Klocman/MSCR/Documentation/Photos/3.jpg

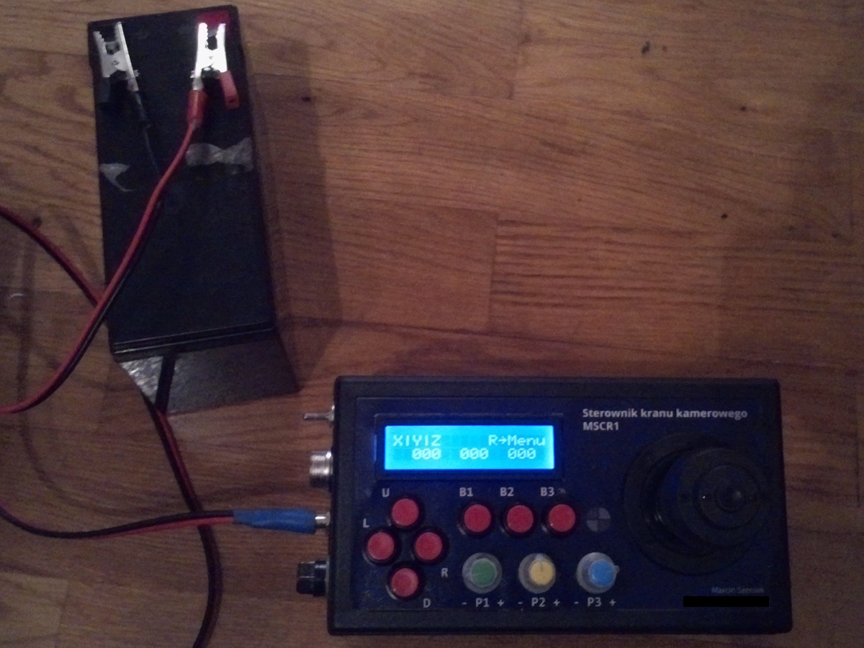
Documentation/Photos/3.jpg
