Klocman/MSCR/Documentation/Photos/4.jpg

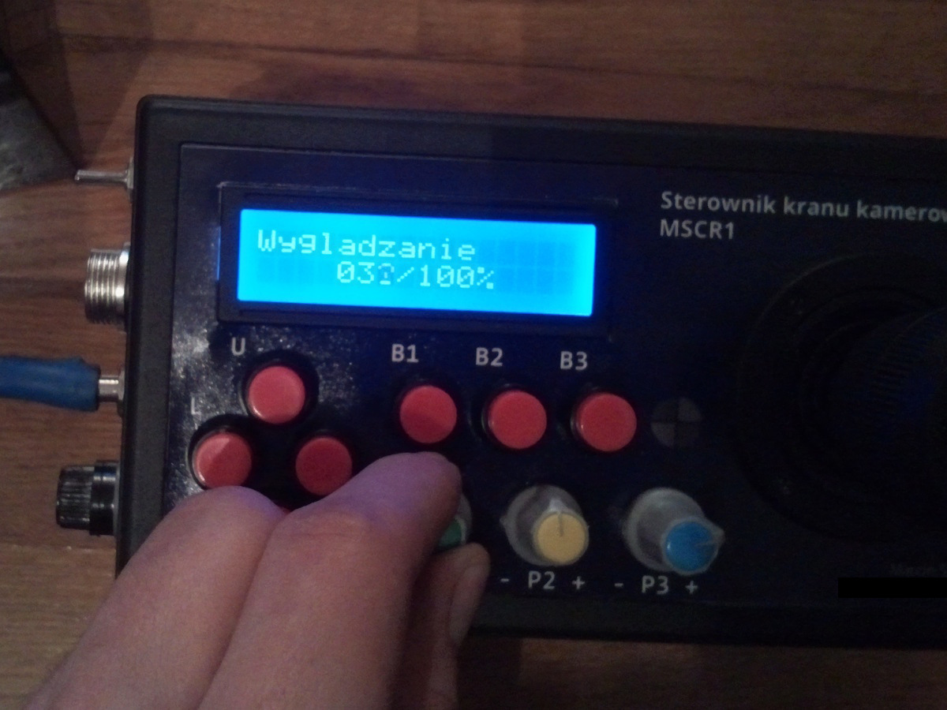
Documentation/Photos/4.jpg
