Klocman/MSCR/Documentation/Photos/5.jpg

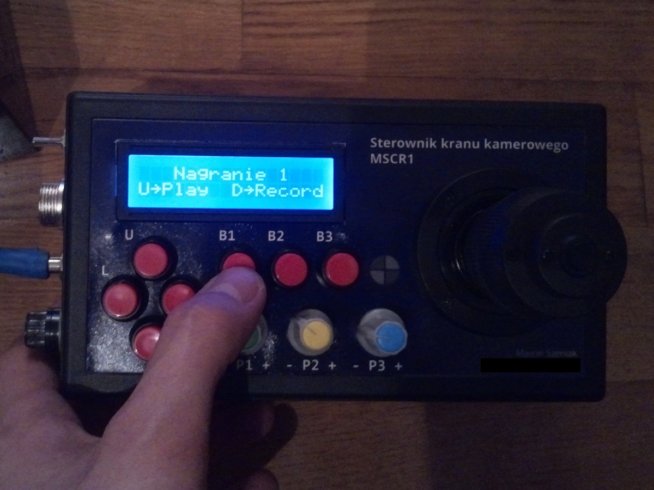
Documentation/Photos/5.jpg
