Klocman/MSCR/Documentation/Photos/7.jpg

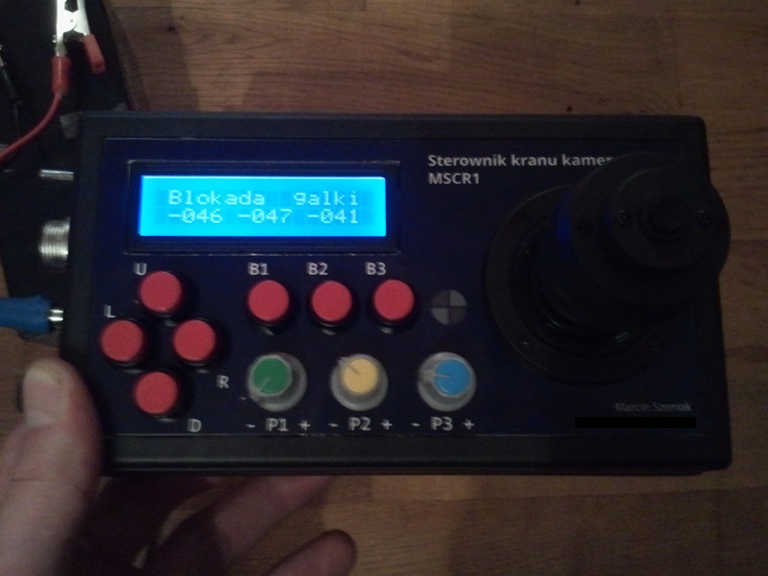
Documentation/Photos/7.jpg
