Klocman/MSCR/Hardware/main.brd

## EAGLE design Hardware/main.brd (2016-10-11)

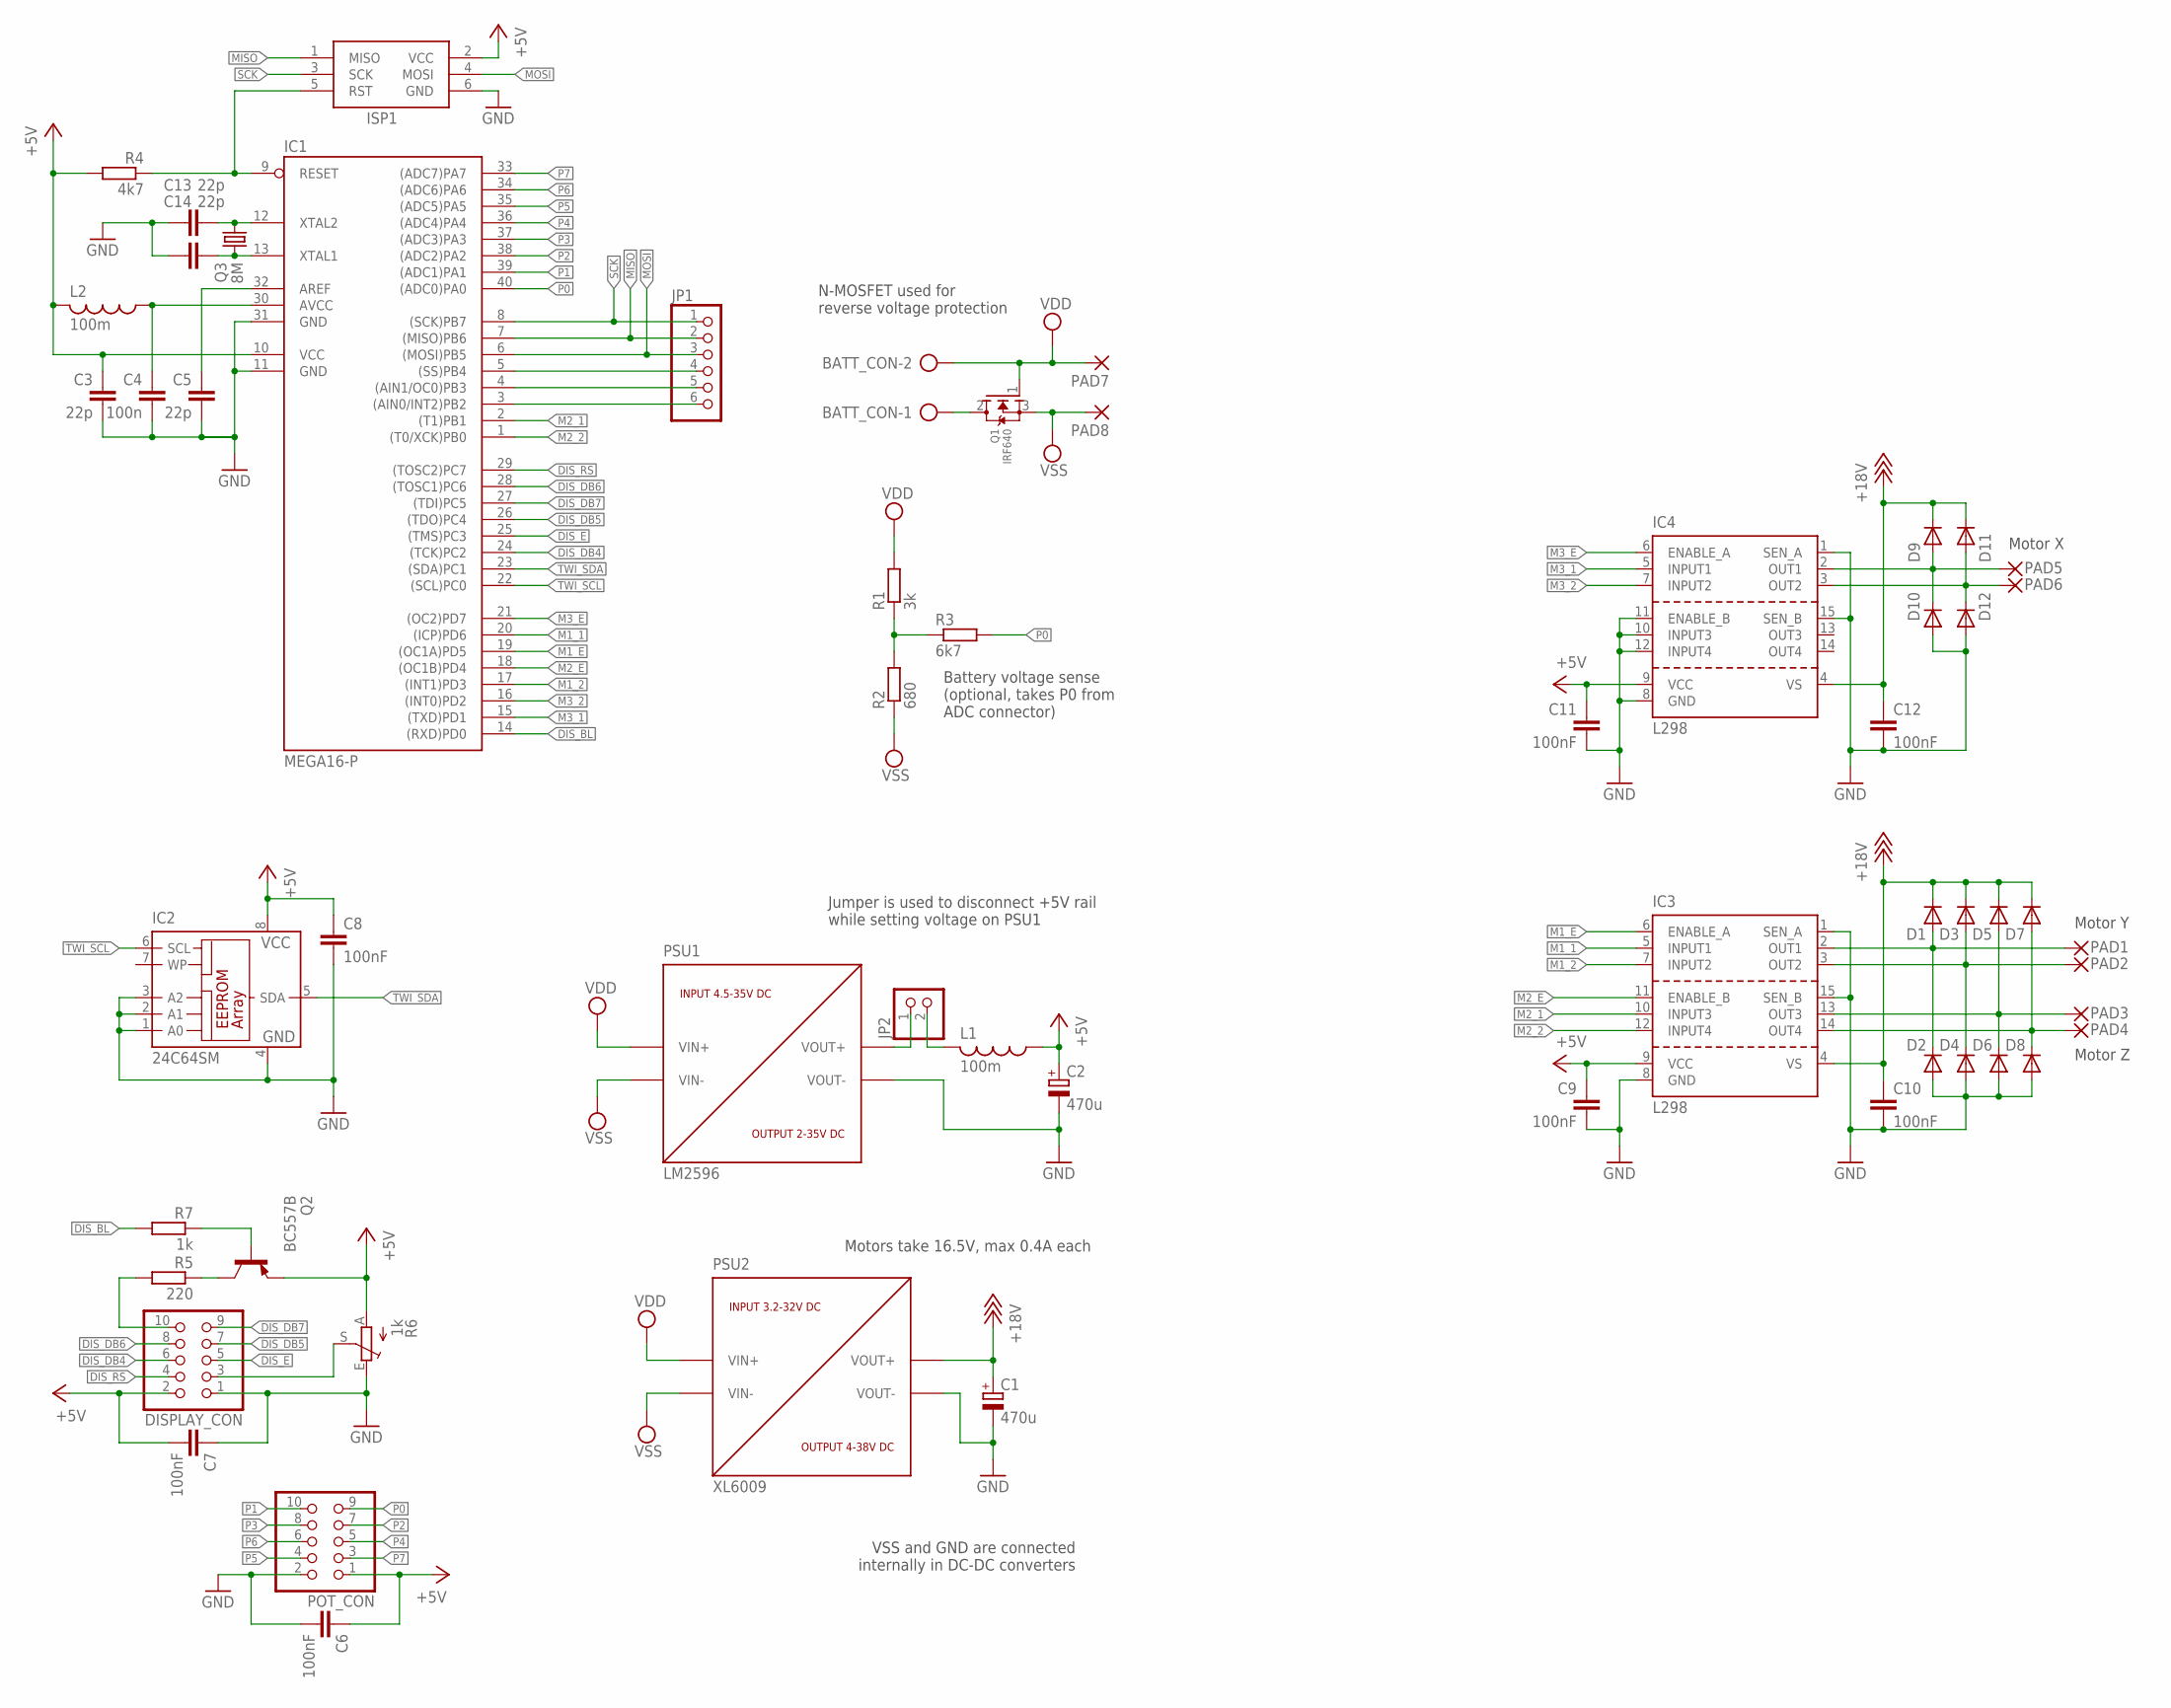
[picture p8: schematic main.sch]

Parts:
BATT_CON: AK500/2-H
C1: 470u; E3,5-8
C2: 470u; E5-8,5
C3, C5, C13, C14: 22p; C025-025X050
C4: 100n; C025-025X050
C6: 100nF; C025-025X050
C7, C8: 100nF; C050-024X044
C9, C10, C11, C12: 100nF; C075-032X103
D1, D2, D3, D4, D5, D6, D7, D8, D9, D10, D11, D12: UF4003; DO41-10
DISPLAY_CON: PINHD-2X5; 2X05
IC1: MEGA16-P; DIL40
IC2: 24C64SM; SO-08M
IC3, IC4: L298; MULTIWATT-15
ISP1: AVRISP-6; AVRISP
JP1: PINHD-1X6; 1X06
JP2: PINHD-1X2; 1X02
L1, L2: 100m; 0204/7
PAD1, PAD2, PAD3, PAD4, PAD5, PAD6, PAD7, PAD8: 2,54/1,1KLOCWIRE1; KLOCWIRE1
POT_CON: PINHD-2X5; 2X05
PSU1: LM2596; DC-DC_CONV_MODULE
PSU2: XL6009; DC-DC_CONV_MODULE
Q1: IRF640; TO220V
Q2: BC557B; TO92-EBC
Q3: 8M; TC26V
R1: 3k; 0204/7
R2: 680; 0204/7
R3: 6k7; 0204/5
R4: 4k7; 0204/5
R5: 220; 0204/7
R6: 1k; CA6V
R7: 1k; 0204/7

Connections:
+5V: C2.+, C3.1, C6.1, C7.2, C8.1, C9.1, C11.1, DISPLAY_CON.2, IC1.10 (VCC), IC2.8 (VCC), IC3.9 (VCC), IC4.9 (VCC), ISP1.2 (VCC), L1.1, L2.2, POT_CON.1, Q2.E, R4.2, R6.A
+18V: C1.+, C10.1, C12.1, D1.C, D3.C, D5.C, D7.C, D9.C, D11.C, IC3.4 (VS), IC4.4 (VS), PSU2.OUT+ (VOUT+)
DIS_BL: IC1.14 ((RXD)PD0), R7.2
DIS_DB4: DISPLAY_CON.6, IC1.24 ((TCK)PC2)
DIS_DB5: DISPLAY_CON.7, IC1.26 ((TDO)PC4)
DIS_DB6: DISPLAY_CON.8, IC1.28 ((TOSC1)PC6)
DIS_DB7: DISPLAY_CON.9, IC1.27 ((TDI)PC5)
DIS_E: DISPLAY_CON.5, IC1.25 ((TMS)PC3)
DIS_RS: DISPLAY_CON.4, IC1.29 ((TOSC2)PC7)
DIS_VO: DISPLAY_CON.3, R6.S
GND: C1.-, C2.-, C3.2, C4.2, C5.2, C6.2, C7.1, C8.2, C9.2, C10.2, C11.2, C12.2, C13.2, C14.2, D2.A, D4.A, D6.A, D8.A, D10.A, D12.A, DISPLAY_CON.1, IC1.11 (GND), IC1.31 (GND), IC2.1 (A0), IC2.2 (A1), IC2.3 (A2), IC2.4 (GND), IC3.1 (SEN_A), IC3.8 (GND), IC3.15 (SEN_B), IC4.1 (SEN_A), IC4.8 (GND), IC4.10 (INPUT3), IC4.11 (ENABLE_B), IC4.12 (INPUT4), IC4.15 (SEN_B), ISP1.6 (GND), POT_CON.2, PSU1.OUT- (VOUT-), PSU2.OUT- (VOUT-), R6.E
M1_1: IC1.20 ((ICP)PD6), IC3.5 (INPUT1)
M1_2: IC1.17 ((INT1)PD3), IC3.7 (INPUT2)
M1_E: IC1.19 ((OC1A)PD5), IC3.6 (ENABLE_A)
M2_1: IC1.2 ((T1)PB1), IC3.10 (INPUT3)
M2_2: IC1.1 ((T0/XCK)PB0), IC3.12 (INPUT4)
M2_E: IC1.18 ((OC1B)PD4), IC3.11 (ENABLE_B)
M3_1: IC1.15 ((TXD)PD1), IC4.5 (INPUT1)
M3_2: IC1.16 ((INT0)PD2), IC4.7 (INPUT2)
M3_E: IC1.21 ((OC2)PD7), IC4.6 (ENABLE_A)
MISO: IC1.7 ((MISO)PB6), ISP1.1 (MISO), JP1.2
MOSI: IC1.6 ((MOSI)PB5), ISP1.4 (MOSI), JP1.3
unnamed: JP2.1, PSU1.OUT+ (VOUT+)
unnamed: DISPLAY_CON.10, R5.2
unnamed: IC1.5 ((SS)PB4), JP1.4
unnamed: IC1.4 ((AIN1/OC0)PB3), JP1.5
unnamed: IC1.3 ((AIN0/INT2)PB2), JP1.6
unnamed: BATT_CON.1, Q1.2 (D)
unnamed: D1.A, D2.C, IC3.2 (OUT1), PAD1.1
unnamed: D3.A, D4.C, IC3.3 (OUT2), PAD2.1
unnamed: D5.A, D6.C, IC3.13 (OUT3), PAD3.1
unnamed: D9.A, D10.C, IC4.2 (OUT1), PAD5.1
unnamed: D7.A, D8.C, IC3.14 (OUT4), PAD4.1
unnamed: D11.A, D12.C, IC4.3 (OUT2), PAD6.1
unnamed: C13.1, IC1.12 (XTAL2), Q3.2
unnamed: Q2.C, R5.1
unnamed: C14.1, IC1.13 (XTAL1), Q3.1
unnamed: JP2.2, L1.2
unnamed: Q2.B, R7.1
unnamed: C4.1, IC1.30 (AVCC), L2.1
unnamed: C5.1, IC1.32 (AREF)
unnamed: R1.1, R2.2, R3.1
unnamed: IC1.9 (RESET), ISP1.5 (RST), R4.1
P0: IC1.40 ((ADC0)PA0), POT_CON.9, R3.2
P1: IC1.39 ((ADC1)PA1), POT_CON.10
P2: IC1.38 ((ADC2)PA2), POT_CON.7
P3: IC1.37 ((ADC3)PA3), POT_CON.8
P4: IC1.36 ((ADC4)PA4), POT_CON.5
P5: IC1.35 ((ADC5)PA5), POT_CON.4
P6: IC1.34 ((ADC6)PA6), POT_CON.6
P7: IC1.33 ((ADC7)PA7), POT_CON.3
SCK: IC1.8 ((SCK)PB7), ISP1.3 (SCK), JP1.1
TWI_SCL: IC1.22 ((SCL)PC0), IC2.6 (SCL)
TWI_SDA: IC1.23 ((SDA)PC1), IC2.5 (SDA)
VDD: BATT_CON.2, PAD7.1, PSU1.IN+ (VIN+), PSU2.IN+ (VIN+), Q1.1 (G), R1.2
VSS: PAD8.1, PSU1.IN- (VIN-), PSU2.IN- (VIN-), Q1.3 (S), R2.1

Notes on the sheet:
Battery voltage sense (optional, takes P0 from ADC connector)
VSS and GND are connected internally in DC-DC converters
Motors take 16.5V, max 0.4A each
N-MOSFET used for reverse voltage protection
Jumper is used to disconnect +5V rail while setting voltage on PSU1
Motor Y
Motor Z
Motor X

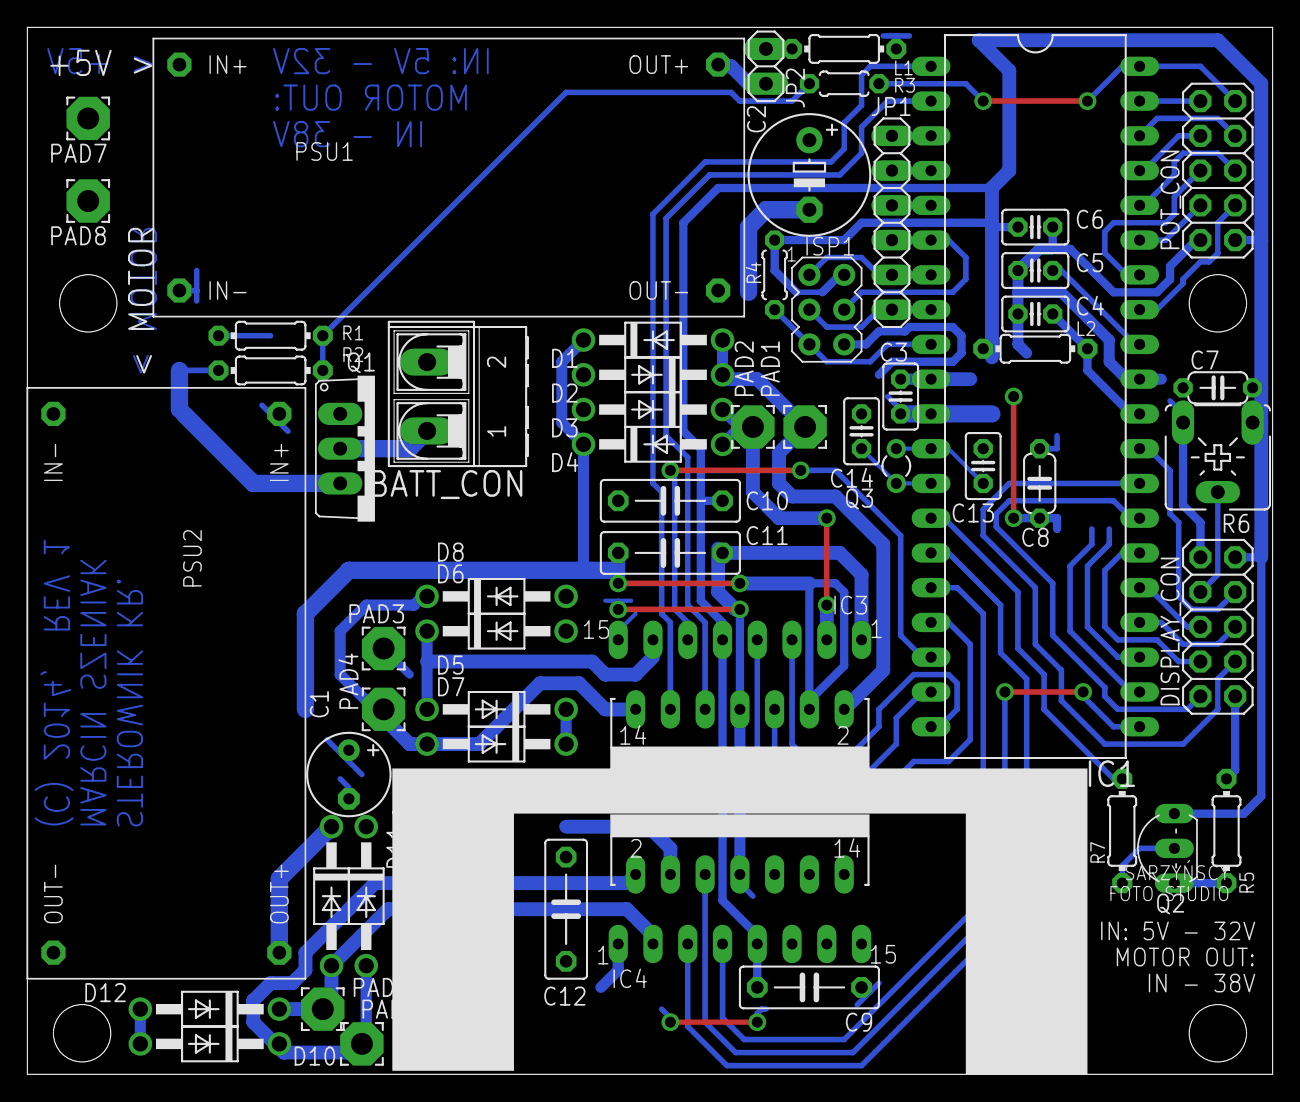
[picture p9: board main.brd from above]

Board: 2 copper layers, 91.0 x 76.5 mm, 59 parts (1 on the bottom side), 56 nets.

Other parts of the board:
U$1: HEATSINK_GN2611
