Klocman/MSCR/(notices)

Notices in the files:
Hardware/main.brd:
(C) 2014, REV 1
